SaxicolousFox/rv32IMB-core/fpga/constraints/arty_a7_100t_pins.txt

# Authoritative port -> pin table for the Digilent Arty A7-100T, extracted
# mechanically from the vendor file.  tb/fpga/check_xdc_pins.py compares every
# fpga/constraints/*.xdc against it.
#
# Source: https://github.com/Digilent/digilent-xdc
#         Arty-A7-100-Master.xdc
# sha256: 5c0c84302cbce49ac85f4812e8f1f7371e686964ec2eb29fd67307da9ed6835f
#
# port                pin    iostandard
CLK100MHZ             E3     LVCMOS33
sw[0]                 A8     LVCMOS33
sw[1]                 C11    LVCMOS33
sw[2]                 C10    LVCMOS33
sw[3]                 A10    LVCMOS33
led0_b                E1     LVCMOS33
led0_g                F6     LVCMOS33
led0_r                G6     LVCMOS33
led1_b                G4     LVCMOS33
led1_g                J4     LVCMOS33
led1_r                G3     LVCMOS33
led2_b                H4     LVCMOS33
led2_g                J2     LVCMOS33
led2_r                J3     LVCMOS33
led3_b                K2     LVCMOS33
led3_g                H6     LVCMOS33
led3_r                K1     LVCMOS33
led[0]                H5     LVCMOS33
led[1]                J5     LVCMOS33
led[2]                T9     LVCMOS33
led[3]                T10    LVCMOS33
btn[0]                D9     LVCMOS33
btn[1]                C9     LVCMOS33
btn[2]                B9     LVCMOS33
btn[3]                B8     LVCMOS33
ja[0]                 G13    LVCMOS33
ja[1]                 B11    LVCMOS33
ja[2]                 A11    LVCMOS33
ja[3]                 D12    LVCMOS33
ja[4]                 D13    LVCMOS33
ja[5]                 B18    LVCMOS33
ja[6]                 A18    LVCMOS33
ja[7]                 K16    LVCMOS33
jb[0]                 E15    LVCMOS33
jb[1]                 E16    LVCMOS33
jb[2]                 D15    LVCMOS33
jb[3]                 C15    LVCMOS33
jb[4]                 J17    LVCMOS33
jb[5]                 J18    LVCMOS33
jb[6]                 K15    LVCMOS33
jb[7]                 J15    LVCMOS33
jc[0]                 U12    LVCMOS33
jc[1]                 V12    LVCMOS33
jc[2]                 V10    LVCMOS33
jc[3]                 V11    LVCMOS33
jc[4]                 U14    LVCMOS33
jc[5]                 V14    LVCMOS33
jc[6]                 T13    LVCMOS33
jc[7]                 U13    LVCMOS33
jd[0]                 D4     LVCMOS33
jd[1]                 D3     LVCMOS33
jd[2]                 F4     LVCMOS33
jd[3]                 F3     LVCMOS33
jd[4]                 E2     LVCMOS33
jd[5]                 D2     LVCMOS33
jd[6]                 H2     LVCMOS33
jd[7]                 G2     LVCMOS33
uart_rxd_out          D10    LVCMOS33
uart_txd_in           A9     LVCMOS33
ck_io0                V15    LVCMOS33
ck_io1                U16    LVCMOS33
ck_io2                P14    LVCMOS33
ck_io3                T11    LVCMOS33
ck_io4                R12    LVCMOS33
ck_io5                T14    LVCMOS33
ck_io6                T15    LVCMOS33
ck_io7                T16    LVCMOS33
ck_io8                N15    LVCMOS33
ck_io9                M16    LVCMOS33
ck_io10               V17    LVCMOS33
ck_io11               U18    LVCMOS33
ck_io12               R17    LVCMOS33
ck_io13               P17    LVCMOS33
ck_io26               U11    LVCMOS33
ck_io27               V16    LVCMOS33
ck_io28               M13    LVCMOS33
ck_io29               R10    LVCMOS33
ck_io30               R11    LVCMOS33
ck_io31               R13    LVCMOS33
ck_io32               R15    LVCMOS33
ck_io33               P15    LVCMOS33
ck_io34               R16    LVCMOS33
ck_io35               N16    LVCMOS33
ck_io36               N14    LVCMOS33
ck_io37               U17    LVCMOS33
ck_io38               T18    LVCMOS33
ck_io39               R18    LVCMOS33
ck_io40               P18    LVCMOS33
ck_io41               N17    LVCMOS33
vaux4_n               C5     LVCMOS33
vaux4_p               C6     LVCMOS33
vaux5_n               A5     LVCMOS33
vaux5_p               A6     LVCMOS33
vaux6_n               B4     LVCMOS33
vaux6_p               C4     LVCMOS33
vaux7_n               A1     LVCMOS33
vaux7_p               B1     LVCMOS33
vaux15_n              B2     LVCMOS33
vaux15_p              B3     LVCMOS33
vaux0_n               C14    LVCMOS33
vaux0_p               D14    LVCMOS33
ck_a0                 F5     LVCMOS33
ck_a1                 D8     LVCMOS33
ck_a2                 C7     LVCMOS33
ck_a3                 E7     LVCMOS33
ck_a4                 D7     LVCMOS33
ck_a5                 D5     LVCMOS33
vaux12_p              B7     LVCMOS33
vaux12_n              B6     LVCMOS33
vaux13_p              E6     LVCMOS33
vaux13_n              E5     LVCMOS33
vaux14_p              A4     LVCMOS33
vaux14_n              A3     LVCMOS33
ck_a6                 B7     LVCMOS33
ck_a7                 B6     LVCMOS33
ck_a8                 E6     LVCMOS33
ck_a9                 E5     LVCMOS33
ck_a10                A4     LVCMOS33
ck_a11                A3     LVCMOS33
ck_miso               G1     LVCMOS33
ck_mosi               H1     LVCMOS33
ck_sck                F1     LVCMOS33
ck_ss                 C1     LVCMOS33
ck_scl                L18    LVCMOS33
ck_sda                M18    LVCMOS33
scl_pup               A14    LVCMOS33
sda_pup               A13    LVCMOS33
ck_ioa                M17    LVCMOS33
ck_rst                C2     LVCMOS33
eth_col               D17    LVCMOS33
eth_crs               G14    LVCMOS33
eth_mdc               F16    LVCMOS33
eth_mdio              K13    LVCMOS33
eth_ref_clk           G18    LVCMOS33
eth_rstn              C16    LVCMOS33
eth_rx_clk            F15    LVCMOS33
eth_rx_dv             G16    LVCMOS33
eth_rxd[0]            D18    LVCMOS33
eth_rxd[1]            E17    LVCMOS33
eth_rxd[2]            E18    LVCMOS33
eth_rxd[3]            G17    LVCMOS33
eth_rxerr             C17    LVCMOS33
eth_tx_clk            H16    LVCMOS33
eth_tx_en             H15    LVCMOS33
eth_txd[0]            H14    LVCMOS33
eth_txd[1]            J14    LVCMOS33
eth_txd[2]            J13    LVCMOS33
eth_txd[3]            H17    LVCMOS33
qspi_cs               L13    LVCMOS33
qspi_dq[0]            K17    LVCMOS33
qspi_dq[1]            K18    LVCMOS33
qspi_dq[2]            L14    LVCMOS33
qspi_dq[3]            M14    LVCMOS33
vsnsvu_n              B17    LVCMOS33
vsnsvu_p              B16    LVCMOS33
vsns5v0_n             B12    LVCMOS33
vsns5v0_p             C12    LVCMOS33
isns5v0_n             F14    LVCMOS33
isns5v0_p             F13    LVCMOS33
isns0v95_n            A16    LVCMOS33
isns0v95_p            A15    LVCMOS33
