SaxicolousFox/rv32IMB-core/sw/bench/bench_lib.c

/*
 * The <string.h> functions Dhrystone and CoreMark reach for.  They are on the
 * benchmark's critical path (Dhrystone's inner loop is three strcpy calls and
 * one strcmp), so they are deliberately the obvious byte-at-a-time versions.
 * Built with -fno-builtin and -fno-tree-loop-distribute-patterns so GCC does
 * not turn a definition into a call to itself.
 */
#include <stddef.h>

void *memcpy(void *d, const void *s, size_t n)
{
    unsigned char *dp = (unsigned char *)d;
    const unsigned char *sp = (const unsigned char *)s;
    while (n--)
        *dp++ = *sp++;
    return d;
}

void *memmove(void *d, const void *s, size_t n)
{
    unsigned char *dp = (unsigned char *)d;
    const unsigned char *sp = (const unsigned char *)s;
    if (dp < sp) {
        while (n--)
            *dp++ = *sp++;
    } else {
        dp += n;
        sp += n;
        while (n--)
            *--dp = *--sp;
    }
    return d;
}

void *memset(void *d, int c, size_t n)
{
    unsigned char *dp = (unsigned char *)d;
    while (n--)
        *dp++ = (unsigned char)c;
    return d;
}

int memcmp(const void *a, const void *b, size_t n)
{
    const unsigned char *x = (const unsigned char *)a;
    const unsigned char *y = (const unsigned char *)b;
    while (n--) {
        if (*x != *y)
            return (int)*x - (int)*y;
        x++; y++;
    }
    return 0;
}

size_t strlen(const char *s)
{
    const char *p = s;
    while (*p)
        p++;
    return (size_t)(p - s);
}

char *strcpy(char *d, const char *s)
{
    char *r = d;
    while ((*d++ = *s++) != '\0')
        ;
    return r;
}

int strcmp(const char *a, const char *b)
{
    while (*a && *a == *b) {
        a++; b++;
    }
    return (int)(unsigned char)*a - (int)(unsigned char)*b;
}

char *strcat(char *d, const char *s)
{
    char *r = d;
    while (*d)
        d++;
    while ((*d++ = *s++) != '\0')
        ;
    return r;
}
