SaxicolousFox/rv32IMB-core/(commit log)

2026-08-28 P0.1/P0.2: toolchain env, repo skeleton, and regression runner
    Phase 0 infrastructure per the development plan.
    P0.1 — tools verified by actually running them, not just --version:
    * Verilator 5.050 (system), Yosys 0.68, SymbiYosys 0.68 via OSS CAD Suite.
    * Solvers: bitwuzla (primary), boolector, z3 — all three verified to both
    prove a true assertion and refute a false one.
    * cocotb 2.0.1 on a uv-provided CPython 3.13 (Ubuntu 26.04's 3.14 is
    unsupported by cocotb).
    * RISC-V toolchain switched to xPack riscv-none-elf-gcc 15.2.0: the
    riscv-collab prebuilt is single-multilib (rv32imafdc/ilp32d only) and has
    no rv32i/ilp32 libgcc or newlib, which this RV32I target req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
2026-08-28 P0.1: Spike built from source and verified; add spike smoke test to regress
    Spike 1.1.1-dev built from riscv-isa-sim source (not packaged, since Track C1
    patches it). Verified it executes a bare-metal RV32I ELF, exits 0 via HTIF,
    reports failure for a deliberately wrong program, and emits the --log-commits
    format the A5 cosim differ will consume.
    [run_spike_smoke.py]
2026-08-28 P0.4: fix set -e/pipefail aborts in patches.sh
    grep, ls-glob and find all exit nonzero for the 'nothing there' case, and under
    set -e with pipefail that aborted the script instead of yielding an empty pin or
    a zero count. Surfaced as 'status' silently omitting the llvm row and exiting 1.
2026-08-28 P0.4: pin LLVM at llvmorg-22.1.8 and create its (empty) xkntt branch
2026-08-28 P0.5: blinky + UART + BRAM readback bitstream and Vivado batch flow
    De-risks the FPGA flow before the core exists: XDC syntax, MMCM, reset
    synchroniser, BRAM inference with $readmemh init, USB-UART pinout, and a
    non-project batch Tcl build.
    Design choices worth noting:
    * Core clock is 75 MHz, deliberately NOT 100 MHz -- a pass-through would prove
    nothing about the MMCM. led[0] counts 1 Hz in the raw oscillator domain and
    led[1] counts 1 Hz in the MMCM domain, so the two must stay visibly in
    lockstep. Judging one LED's absolute rate by eye is unreliable; spotting two
    LEDs drifting apart is easy. A wrong 100 MHz ratio shows within seconds.
    * The BRAM checksum is PRINTED over UART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
    [arty_a7_100t.xdc, rvntt_blinky_top.sv, rvntt_bram_selftest.sv, rvntt_clkgen.sv, rvntt_sync_reset.sv]
2026-08-28 P0.5: fix UART banner repeating 15x/second instead of once
    Found on hardware. The report FSM declared a hardcoded 27-bit wait counter and
    compared it against CLK_HZ/16, so the gap was 62.5 ms rather than 1 s -- about
    15 lines/second. The comment said 'roughly one line per second', which is
    exactly why it survived review: the constant had been scaled to fit an assumed
    counter width instead of the width being derived from the constant. 75,000,000
    fits in 27 bits anyway, so the /16 was both unnecessary and wrong.
    Now GAP_CYCLES = CLK_HZ and the width comes from $clog2(GAP_CYCLES+1).
    The real defect was in the testbench: it read exactly one message and stopped,
    so nothing ever observed the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
    [rvntt_uart_report.sv, tb_blinky_uart.cpp]
2026-08-29 C0: the .insn bridge -- xkntt.h plus its encoding and emulation tests
    sw/include/xkntt.h emits every Xkntt instruction from ordinary C using stock
    GNU as, so Track A bring-up and the C6 software stack are not blocked on the
    LLVM backend. XKNTT_EMULATE=1 gives the same semantics in portable C, which
    makes a full-length host KAT run affordable.
    tb/unit/test_insn_bridge.py compiles the header at -O0 and -O2, disassembles,
    and decodes every custom-opcode word with model/isa/xkntt.py, then round-trips
    it back to the exact bit pattern. Fault-injected three ways (wrong funct3,
    R4 emitted as R, a dropped term in the emulation); all three were caught.
    Deviation from the plan's C0 snippet: Tier-1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
2026-08-29 C0 and C1: the .insn bridge, and Spike executing the Xkntt extension
    C0 -- sw/include/xkntt.h emits all ten instructions from ordinary C with stock
    LLVM backend. XKNTT_EMULATE=1 gives the same semantics in portable C, which is
    what makes a full-length host KAT run take seconds instead of an hour.
    Committed separately in 81d333c.
    C1 -- toolchain/spike-src carries three patches now: the ISA-string parser
    (P0.4), the extension implementation, and its integration. Spike executes
    ML-KEM-768 using kbfct, kbfgs, kbmul0, kbmul1 and kmm, and produces
    KAT-matching keys.
    The chain of evidence for that claim, weakest link f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
2026-08-29 Document the push cadence, and the main-vs-master trap
    origin is now configured and authenticated, and main tracks origin/main, so
    the milestone workflow gains a publish step: update the milestone table,
    commit, tag with a self-sufficient annotation, then push branch and tags.
    Push at milestone and track/phase boundaries -- not per commit, and never
    leaving a met milestone unpushed.
    Also flags a trap the rename created. toolchain/patches.sh and
    toolchain/upstream-pins.txt both name origin/master, and that is correct:
    it refers to riscv-isa-sim's default branch, not this repo's. An agent
    tidying up after the master->main rename would break patches.sh rebase,
    and the breakage would not surf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
2026-08-29 Commit the plan document so every clone and worktree has it
    Reverses the gitignore from the previous commit at the author's direction --
    the document is his own and there is no reason to withhold it.
    This closes the gap that commit flagged: a worktree agent without the plan
    would have had to reconstruct it, and the most likely reconstruction of
    section 3 is the kbfgs butterfly with (a - b), which yields a working forward
    NTT and a silently broken inverse. That bug has already been found and paid
    for once in this project; having the real document in the tree means nobody
    re-derives the wrong version of it.
    64 KB of text, so no reason to treat it as a large asset.
    The doc table now frames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
2026-08-29 A1: the RV32I type package and the three-port register file
    Track A's first RTL. Two files: rv32i_pkg.sv, holding the opcode/funct3/funct7
    constants and the four pipeline-register packed structs, and rvntt_regfile.sv,
    the 32x32 architectural register file.
    Three read ports, not two. Plan section 1.1 took the R4-type recommendation, so
    kbmul0 and kmac read rs3 as well as rs1/rs2. Retrofitting a third port later
    would mean re-timing ID, so it is here from the start; it costs one more
    distributed-RAM copy of the array and does not touch the critical path.
    Write-through is a correctness simplification rather than an optimisation: it
    makes a WB write visible to an ID read in the same cycle, whi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
    [rv32i_pkg.sv, rvntt_regfile.sv, tb_regfile.cpp, test_regfile_verilator.py]
2026-08-29 A3: the instruction decoder, and two things random testing could not find
    rvntt_decode.sv decodes RV32I + Zicsr + Xkntt into the ctrl_t bundle, compared
    against model/rv32i_ref.py::decode over 10^6 random words with zero mismatches.
    The custom opcodes are not decoded twice. The Python side delegates custom-0 and
    custom-1 to model/isa/xkntt.py -- the frozen contract -- rather than
    reimplementing the rules. The four-way agreement in the root CLAUDE.md is
    DEFINED on that contract, and a second hand-written copy could agree with the
    RTL while both drifted away from it.
    Legality is the substance of this module, and it follows three rules that are
    genuinely different from each other. Xkntt reser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
    [run_cocotb.py, rvntt_decode.sv, rvntt_decode_flat.sv, test_decode_cocotb.py]
2026-08-29 A4: the pipeline skeleton, and six mutations that escaped a one-register check
    Five stages wired together with no forwarding, no stalls and no flushes, plus
    rvntt_ram (true dual-port, the whole memory system) and a simulation top. The
    acceptance program is sw/tests/a4_checksum.S: a straight-line, NOP-padded,
    order-sensitive checksum over 16 words, followed by a tail that exercises every
    load and store width. It retires 477 instructions and produces 0xec22896c,
    agreeing with a Python model and with Spike.
    The omissions are the design, not a to-do list, and the dangerous one is the
    absence of control flow. dbg_unsupported pulses whenever an instruction retires
    that this core cannot execute fa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
    [rvntt_core.sv, rvntt_core_sim_top.sv, rvntt_ram.sv, tb_core.cpp, test_core_verilator.py]
2026-08-29 A5: the commit-log tracer and the Spike differ
    The plan calls this the highest-return item in Track A, and it is now in place:
    rvntt_trace.sv emits one line per retiring instruction in Spike's
    --log-commits format, and tb/cosim/commit_diff.py runs both on the same ELF and
    reports the first divergent line with context on either side. The hand-written
    A4 checksum program and 500 generated random programs of 400 instructions each
    have been run byte-identical; the regression runs 100.
    Equality is defined by a single renderer. Both logs are parsed into (pc, insn,
    writes) records and rendered back out through commit_diff.render(), so
    "byte-identical" is literally true while being immune to a form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
2026-08-29 A6: forwarding, and a formal proof that was checking itself
    The forwarding unit resolves EX/MEM -> EX and MEM/WB -> EX for both operands,
    with the younger producer winning and a producer whose rd is x0 supplying
    nothing. 1000 random programs at --raw-density 1.0 -- no padding at all between
    a producer and its consumer -- are byte-identical against Spike, and
    sw/tests/a6_forward.S covers the cases too specific to appear by chance,
    including the plan's own priority test verbatim.
    Two structural decisions are worth the words.
    A load in MEM is NOT a forwarding source, even though its data is available by
    then: rvntt_ram registers the address back in EX. Forwarding it would work, and
    would put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
    [run_mutation.py, rv32i_pkg.sv, rvntt_core.sv, rvntt_forward.sv, test_core_verilator.py, test_cosim_directed.py]
2026-08-29 A7: the load-use interlock, and a check the commit log cannot make
    The interlock is plan A7 verbatim: a load in EX whose rd is read by the
    instruction in ID holds IF and ID for one cycle and puts a bubble into EX.
    1000 random programs at --raw-density 1.0 --load-use-density 1.0 are
    byte-identical against Spike, and sw/tests/a7_loaduse.S covers the specific
    shapes -- the store-data operand, the load address, `lw x0`, and the cases that
    must NOT stall.
    One cycle is enough because of this pipeline's memory timing rather than
    because of the textbook. Without the stall the consumer reaches EX while the
    load is in MEM, and FWD_MEM deliberately does not carry load data; with one
    stall the load is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
    [commit_diff.py, cycle_model.py, gen_random_prog.py, run_mutation.py, rvntt_core.sv, rvntt_hazard.sv, tb_core.cpp]
2026-08-29 A8: control hazards, and M4 -- the pipeline in lockstep with Spike
    Branches resolve in EX, and a taken branch or a jump redirects the PC and
    squashes both younger instructions in flight. That closes A4's last deliberate
    omission, so dbg_unsupported now flags only illegal instructions, Xkntt, and a
    CSR access that writes a register.
    M4's "Done when" is 1000 random programs passing lockstep cosim against Spike.
    1000/1000 are byte-identical at --raw-density 1.0 --load-use-density 1.0
    --branch-density 0.12, with every program's CYCLE SPAN also matching the
    independent model -- so the claim is about timing as well as values. Branch
    density is the one knob not run at 1.0: a program made entirely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
    [cycle_model.py, gen_random_prog.py, run_mutation.py, rvntt_branch.sv, rvntt_core.sv, test_core_verilator.py, test_cosim_directed.py]
2026-08-30 A9: CSRs, traps and MRET -- and a counter in the wrong stage
    Zicsr, the machine-mode CSR set, 64-bit mcycle/minstret, trap entry and MRET.
    Plan A9's two done-when clauses are both met: the machine-mode riscv-tests pass,
    and minstret after a known program equals the instruction count Spike reports
    for it.
    54 of 54 riscv-tests pass -- the full rv32ui-p and rv32mi-p sets -- with four
    skipped for reasons that are features rather than gaps: fence_i (Zifencei is not
    in the target ISA), ma_data (wants misaligned access to SUCCEED, which this core
    traps on and the *-misaligned tests check instead), breakpoint (debug triggers)
    and pmpaddr (PMP). Every test runs on Spike first, so a broken build cann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
    [commit_diff.py, run_mutation.py, rv32i_pkg.sv, rvntt_core.sv, rvntt_core_sim_top.sv, rvntt_csr.sv, rvntt_trace_top.sv]
2026-08-30 A10: RISCOF compliance, and four ways to a report that means nothing
    76 of 76 selected riscv-arch-test tests pass with Spike as the reference model:
    38/38 of the RV32I I suite, 22 hints and 16 privilege, the last including the
    misaligned load, store and JALR cases. The HTML report is committed at
    docs/riscof-report.html. That is M5.
    Four corrections stand between a first run and a report worth reading, and each
    would otherwise have produced a plausible wrong answer.
    RISCOF'S EXIT CODE IS NOT THE VERDICT. `riscof run` returns 0 for a run in which
    tests failed, and the first version of run_riscof.py printed RISCOF_OK over 50
    real failures. The verdict now comes from parsing the report, and a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
    [tb_core.cpp]
2026-08-30 A11: riscv-formal, and a forwarding mux that disagreed with its own writeback
    43 riscv-formal checks now pass at BMC depth 14 -- the 36 RV32I instruction
    models plus reg, pc_fwd, pc_bwd, causal, liveness and unique -- which is plan
    A11's done-when and milestone M6.
    THE PLAN IS WRONG THAT THE COMMIT TRACER IS ENOUGH. It says to wire RVFI out of
    the existing tracer because "the information is the same, in a standardized
    form". It is not: riscv-formal requires a TRAPPING instruction to be reported
    with rvfi_trap set, and A9's trap invariant squashes the faulting instruction in
    EX so it never reaches WB. That squash is load-bearing -- it is what keeps the
    commit log line-for-line comparable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
    [run_mutation.py, run_riscv_formal.py, rvntt_core.sv, rvntt_rvfi.sv, rvntt_rvfi_wrapper.sv]
2026-09-01 A12: a CPU on the board, and the two mutations that only the stimulus could catch
    rvntt_soc_top is rvntt_core plus a 128 KB dual-port BRAM plus a memory-mapped
    UART and GPIO. It loads, it runs a program out of BRAM, and "Hello, world!"
    arrives over the USB-UART from the actual FPGA -- which is A12's done-when,
    met. Fmax is 73.121 MHz on Vivado 2025.2, xc7a100tcsg324-1, -1 speed grade,
    default strategy.
    Almost nothing here is new hardware. P0.5 put the MMCM, the reset
    synchroniser, the UART transmitter, the XDC idiom and the batch Tcl flow on
    this board already, and reusing them meant that when something went wrong it
    was one of the parts A12 actually added. The only change to proven RTL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
    [arty_a7_100t_soc.xdc, hello.c, parse_soc_uart.py]
2026-09-01 A12 fix: the RGB LED's red and blue were on each other's pins
    Caught by a person looking at the board, which is the whole point of this
    commit. The Digilent master XDC lists the RGB LED as led0_b, led0_g, led0_r --
    in that order. They were read as r, g, b, and E1 and G6 were transposed.
    Everything passed. Verilator lint, Vivado elaboration, synthesis, timing
    closure, bitstream generation, JTAG programming, and an eight-block UART capture
    that was byte-perfect including the receive path and the program's own image
    checksum. A swapped OUTPUT pin is invisible to every one of those, because none
    of them can see past the pad. The entire symptom was that LD0 showed green
    blinking with red so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
    [arty_a7_100t_soc.xdc, check_xdc_pins.py]
2026-09-01 A12: record the LED check as hardware-confirmed, and what cyan means
    The pin-corrected bitstream was verified on the board: LD0 shows blue solid with
    green blinking on top, mixing to cyan once a second, and no red -- so
    dbg_unsupported has never fired. LD4-LD7 count in binary with LD4 as the LSB,
    and sw=0xC btn=0x4 was read back through GPIO_IN with the switches and a button
    physically set, confirming both directions of the GPIO on silicon.
    The colour-mixing note is not decoration. Mixing is what disguised the
    transposed pins in the first place: red plus green reads as orange, and the
    board was reported as "flashing between green and red" rather than as "red is
    on". Someone checking this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
2026-09-01 A13: Dhrystone and CoreMark on the board, and why the scores are computed in Python
    DMIPS/MHz 0.7306, CoreMark/MHz 0.9607, IPC 0.7227 and 0.6930, at 70.129870 MHz
    on the Arty. Three separate JTAG programming passes, three report blocks each;
    all nine identical to the cycle. That closes M7 together with A12's Fmax.
    Both benchmarks live in one bitstream. $readmemh bakes the program into the
    BRAM at synthesis, so a second benchmark is a second fourteen-minute
    implementation run for no measurement benefit -- and on this SoC running
    Dhrystone first cannot perturb CoreMark, because there is no cache, no DRAM
    refresh, no interrupt source and no second bus master. The machine CoreMark
    starts on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
2026-09-02 Spec: RISC-V_NTT_MODS_A.txt -- RV32IM and branch prediction as A14-A18
    Track A finished to its original scope and two of A13's measurements said the
    scope was one extension short of the baseline the plan itself assumes. This is
    the modification document; RISC-V_NTT.txt is not edited, and this commit does
    not touch it.
    The first measurement: the reference ntt(), same source and same -O2, costs
    148,645 instructions on rv32i and 23,795 on rv32im -- 6.25x. Plan B6 estimates
    the software NTT baseline at "roughly 15,000-30,000 cycles". The rv32im figure
    lands inside that band and ours is 7-14x outside it, so B6's estimate was
    written assuming a hardware multiplier while 1.5 scopes the core wit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
2026-09-02 MODS_A: insert an Fmax step, and correct what A12 said its bottleneck was
    Two changes, and the second is why the first exists.
    A12 concluded the SoC is slow because it is spread across the 32 BRAM tiles of
    the 128 KB array, and rtl/soc/CLAUDE.md told anyone pushing past 73 MHz to start
    with a floorplan constraint or a smaller array. Reading the post-route path hop
    by hop says that is overstated. Of the 13.373 ns: 4.56 ns is the forwarding mux
    reaching the ALU operand, 4.44 ns is the ALU RESULT MUX feeding the
    misaligned-address check, 2.14 ns is the trap net (fanout 245) gating the byte
    enables, and only 1.32 ns is the crossing to the BRAM. The core-to-BRAM hop is
    under a fifth of the pa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
2026-09-02 A14+A15: RV32IM, and the two things formal had to be told about
    MODS_A A14 and A15, in ONE commit because A14 on its own leaves a check that
    does not finish. The multiplier makes riscv-formal's existing 43 checks take
    hundreds of seconds each; the abstraction that fixes that, and the RVFI bug
    `reg` found once it could run again, are both A15. Splitting would have left a
    deliberately broken intermediate commit, which is worse than a long message.
    THE MECHANISM WAS BUILT BEFORE THE INSTRUCTIONS, and generically. Plan section
    8 I1 needs a multi-cycle EX unit for Xkntt Tier 1 and building it twice is how
    you get a hazard bug, so rvntt_muldiv presents a req/done handshake with the
    latency a p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
    [bench_main.c, cycle_model.py, gen_random_prog.py, parse_bench_uart.py]
2026-09-02 A16: RV32IM on the board, and what M actually bought
    MODS_A A16. M7.1. Hardware-confirmed: three JTAG programming passes per image,
    four report blocks each, all twelve identical to the cycle -- not within
    tolerance, byte for byte, with parse_bench_uart.py enforcing exact equality.
    THE DUAL BASELINE IS THE POINT OF THE STEP. The same reference ML-KEM NTT,
    compiled -march=rv32i and -march=rv32im and linked into one image, measured on
    one core at one clock within microseconds of itself: 205884 vs 39058 cycles,
    148655 vs 23805 instructions. 6.245x on instructions, against the 6.247x A13
    measured on Spike; the ten extra per side are the counter reads. All 256 output
    coefficients identical b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
2026-09-02 A17-A19: address generation, an instrument that closes, and a branch predictor
    M7.2. Fmax 73.752 -> 86.490 MHz with a dedicated address adder, then back to
    77.501 with a branch predictor that is worth more than the clock it costs:
    Dhrystone IPC 0.6860 -> 0.8752 and DMIPS 63.35 -> 72.43 on a SLOWER part, three
    JTAG passes, twelve report blocks identical to the cycle.
    THESE THREE STEPS ARE ONE COMMIT, AND THAT WAS NOT THE PLAN. A17+A18 and A19
    were developed to be committed separately, and the separation was to be produced
    by mechanically inverting the script that applied A19 -- so that the A17 commit
    would be a tree that builds rather than one missing the address adder. The
    inverse no lon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
    [compare_bench_runs.py, cycle_model.py, gen_random_prog.py, parse_bench_uart.py, project_bpred.py]
2026-09-02 Repoint the hardware regression at A19, which it had silently stopped testing
    bench_hardware programmed fpga/build/bench_a16/rvntt_soc_top.bit and checked
    A16's counters. A19 shipped three steps later. Anyone running
    `RVNTT_HW=1 make regress` would have got a green row certifying a design the
    repository no longer contains -- on a real board, over real JTAG, with
    byte-perfect UART and counters reproducible to 0 ppm. Every part of that
    evidence is genuine except the part that matters.
    The comment directly above the line warned against this in as many words --
    "not by leaving the regression pointed at a stale .bit" -- which is the point.
    The pointer was correct when written and rotted silen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
2026-09-03 A2: the second Track A modifications document, and five things that were checked rather than assumed
    This scopes A20-A30 and milestones M7.3-M7.5: hardware performance counters,
    the B extension plus Zbkb, Zicond, a two-cycle multiply, an Fmax push toward
    110 MHz, Zkr and Zkt. It is written in MODS_A's shape deliberately -- marker
    table first, conflict analysis, per-step Build/Verify/Realistic expectation/
    Stop rule/Done when, a risk register additive to section 11, and milestones
    added to section 12's sequence with explicit "satisfied by" lists.
    Five claims the round depends on were verified by running something rather than
    recalled, and two of them came back the opposite of what the scope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
2026-09-03 A21: B and Zbkb in their own lane, and two checkers that were reporting nothing
    34 instructions -- Zba, Zbb, Zbs and Zbkb -- in rvntt_bitmanip.sv, joined at
    ex_result rather than folded into the ALU. That is the step's central decision
    and it is measured rather than stylistic: MODS_A2 section 3.4 reads the
    post-route critical path hop by hop and puts the ALU's operation-select mux at a
    third of it, with ex_alu_y feeding ex_jump_target and the mispredict compare.
    Folding 34 instructions in would take alu_op_e from four bits to six and add
    about two LUT levels to a path with 0.003 ns of slack, in the round whose other
    goal is to shorten it. ex_result terminates at a pipeline register and doe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
    [gen_random_prog.py, run_cocotb.py, run_mutation.py, run_riscv_formal.py]
2026-09-03 A22, A23 and M7.3: Zicond, the ISA round on hardware, and what B actually bought
    Zicond is two instructions and half a day; the step exists for the measurement,
    and the measurement said something different from what the plan predicted.
    TWO BUILDS COULD NOT SEPARATE ZICOND FROM B. Comparing rv32im against
    rv32im+B+Zicond shows Dhrystone losing 2,000 conditional branches and 3,999
    mispredicts together, which reads as Zicond removing a fifth of the mispredicts.
    It did not. Zbb's min/max are themselves if-conversion instructions and Zba's
    sh*add replace multiplies, so a two-point comparison cannot tell them apart. A
    third build -- B WITHOUT Zicond, which build_bench_image.py grew an rv32imzb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
    [bench_main.c, gen_random_prog.py, parse_bench_uart.py, run_mutation.py, run_stall_profile.py]
2026-09-03 H1: parallelise the mutation harness, and two pre-flights that fail in 20 ms
    The regression had grown to twenty-six minutes and three tests were 84% of it:
    mutation_pipeline 1284 s, riscv_formal 295 s, formal_muldiv 181 s, with the
    other 46 tests summing to 180 s. Measuring first was the whole point -- the
    growth was concentrated, not broad, and only one of the three was structural
    rather than solver time.
    MUTATION TESTING IS NOW PARALLEL: 1151 s -> 547 s on identical code, and the
    serial and parallel reports are BYTE-IDENTICAL. That is verified, not assumed,
    and it is why results are collected and printed in manifest order rather than
    as they complete: this table is meant to be diffable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
    [run_mutation.py, run_riscv_formal.py, test_isa_consistency.py]
2026-09-04 A24: the Tier-1 butterfly closes at 128 MHz, and three ways I nearly believed otherwise
    MODS_A2 3.3 settled that Tier-1 Xkntt shares the core's clock -- isa-spec.md
    freezes kmm at 4 cycles of EX occupancy and a clock-domain crossing costs more
    than that before any arithmetic happens -- so the core's Fmax is a hard floor
    the butterfly has to meet. Committing the core to a number Track B cannot reach
    would be section 9's failure mode fired at M15, two tracks from its cause. This
    takes the evidence first.
    Fmax = 128.125 MHz for the arrangement the frozen table actually asks for, on
    xc7a100tcsg324-1 at the -1 speed grade, out of context. 2 DSP48E1, 326 LUTs,
    150 FFs; 132.500 MHz is the faste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
2026-09-04 A25: three-cycle multiply, and a saving Dhrystone does not get because B already took it
    MODS_A2 A25. A14 built the multiplier as three named registers -- operand,
    product, delay -- with MULDIV_MUL_CYCLES hardcoded at 4 beside them, related
    only by a comment. The depth is now DERIVED from the latency, MUL_PIPE =
    MUL_CYCLES - 2, so the two cannot drift; MUL_CYCLES is a module parameter
    defaulted from the package purely so synth_ooc.sh can sweep it, nothing
    instantiates it differently, and isa_consistency now checks both halves of that.
    Both checks were fault-injected.
    Out of context the unit clears 160 MHz at 4 cycles, at 3 AND at 2, with the
    worst register-to-register path inside the DSP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
    [run_mutation.py, rv32i_pkg.sv, rvntt_muldiv.sv, test_isa_consistency.py]
2026-09-04 A26-A28 and M7.4: 96.246 MHz without moving a cycle, and a lever the plan did not list
    MODS_A2's performance phase. Fmax 74.577 -> 96.246 MHz, +29.1%, with every
    benchmark counter on the board identical to A25's and both identity residuals
    still exactly -40 and -48 -- the same two numbers A23 measured, out of a design
    whose forwarding network, jump-target adder and predictor lookup were all
    rebuilt. DMIPS 65.53 -> 90.10, CoreMark 229.95 -> 326.24, three JTAG passes
    with all 42 integer counters identical across fifteen report blocks.
    A26's three levers, each measured at one constraint so the deltas compare:
    JALR onto A17's address adder +0.073 ns, the forwarding decision precomputed in
    ID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
2026-09-05 A29, A30 and M7.5: Zkr with an uncertified source, and a Zkt claim with both boundaries
    MODS_A2's cryptographic round. ISA is now
    RV32IMZicsr_Zicond_Zba_Zbb_Zbkb_Zbs_Zkr_Zkt, RISCOF 120/120, and the ring
    oscillator is in a real bitstream at 96.246 MHz with all 42 benchmark counters
    identical to A28's over three JTAG passes. Zkr costs no cycles.
    THE ENTROPY SOURCE IS UNCERTIFIED and the write-up says so before it says
    anything else. No SP 800-90B validation campaign has been run; ES16's specified
    meaning is entropy meeting that standard and this does not establish it. There
    is no cryptographic conditioning, H = 1 bit/sample is an assumption rather than a
    measurement, and no output of the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
    [run_formal.py, run_mutation.py, run_riscv_formal.py, run_zkt.py]
2026-09-05 Track A closing report, and a roadmap that prices what is left
    Two documents for the post-A30 core, written from the commit history, the
    per-step write-ups and the committed JSON records rather than from memory.
    No RTL, no harness and no measurement changed; the pre-flights were run
    anyway because the norm is to run them.
    docs/core-report-a30.md is the state-and-chronology report. Part I is the
    machine as it stands in every dimension that matters; Part II is A1 through
    A30, each step in the same shape -- what the machine was, what changed and
    why, what went wrong on the way, and the result; Part III is the six patterns
    that recurred often enough to be worth naming. The convention througho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
2026-09-11 Bring the documented ISA string up to date, and make isa_consistency check it
    A21-A30 widened the core seven extensions past rv32im_zicsr_zicntr_xkntt0p1,
    and every place that states the ISA string for a human to read kept the old
    one: docs/isa-spec.md, docs/spike-xkntt.md, rtl/core/CLAUDE.md, and the
    headers of rvntt_decode.sv and model/rv32i_ref.py. isa_consistency did not
    notice, because it watches only the six strings the tools actually consume --
    the ones that hang a run when they narrow. A copy in prose cannot hang
    anything, so it drifts instead. The same thing happened to isa-spec.md once
    already, after A14.
    All five now read rv32im_zba_zbb_zbs_zbkb_zicond_zkr_zkt_zicsr_zicntr_xkntt0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
    [rvntt_decode.sv, test_isa_consistency.py]
2026-09-11 Stand this copy up as rv32IMB-core, independent of riscv-ntt
    This repository is a full-history copy of riscv-ntt taken at ec887a1, to be
    cut down to the RV32 core. This commit changes only what the two trees would
    otherwise share, and nothing about the design.
    The Windows staging directories are renamed from C:\Users\liamf\rvntt-* to
    rv32imb-core-* in all six scripts that default to one: build_fpga.sh,
    build_soc.sh, elab_core.sh, synth_ooc.sh, hw_bringup.py and
    serial_capture.ps1. Each build script rm -rf's its staging directory before
    it runs, so with shared names a Vivado run in one tree would silently destroy
    a run in progress in the other. They share a machine and a board, so this is
    no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
2026-09-11 Give this tree its own temp build directories, so no build is shared with riscv-ntt
    Eleven tests build into fixed names under tempfile.gettempdir():
    rvntt_obj_{sync_reset,regfile,blinky,soc,bench,entropy,prof,tier1_N}, plus
    rvntt_cocotb_<design> and rvntt_tier1_vectors.txt. riscv-ntt uses the same
    names, so the two trees were sharing Verilator and cocotb object directories.
    make in one tree read the other tree's stale .d files, and would reuse
    objects compiled from the other tree's sources whenever that tree had built
    more recently. The names are now rv32imb_core_*, alongside the Windows
    staging directories 40aefac renamed for the same reason. mkdtemp users are
    unique per run already and are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
    [run_cocotb.py, run_stall_profile.py, test_bench_verilator.py, test_blinky_verilator.py, test_entropy_health.py, test_regfile_verilator.py, test_soc_verilator.py, test_sync_reset_verilator.py]
2026-09-12 Strip the NTT coprocessor and the ML-KEM software from the tree
    This repository is the RV32IMB core alone. Everything that existed only for
    the Xkntt coprocessor or the ML-KEM application goes: the Xkntt Python model,
    its Spike patches and the patch-sync check, the sw/kyber KAT build and its
    seed-CSR disassembly test, the Tier-1 timing probe, the NTT and Keccak
    benchmark sections and their pq-crystals checkout dependency, the plan
    documents and per-step reports, and every CLAUDE.md.
    The core RTL loses the Xkntt decode with it. custom-0 and custom-1 previously
    decoded as legal, retired writing zero to rd and lit a debug LED; they are now
    illegal instructions and trap, which is what upstrea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
